HadleyResearch/CardPOV/Documentation/CardPOV_v1.0_BOM.ods

Sheet: BOM
 |  |  |  |  | Document: | Bill of Materials
 |  |  |  |  | Last Modified: | Last_Modified_Date
 |  |  |  |  | Project: | Project Name
 |  |  |  |  | Project Version: | Project_Version
 |  |  |  |  | Author: | Author_Name
Main Board
Description | ID | Qty | Value | Package | Manufacturer | Mfg. Part # | Supplier | Supplier Part #
Microcontroller |  | 1 |  | SSOP-28 | Microchip | PIC18F25J50 | DigiKey | PIC18F25J50-I/SS-ND
Battery Holder |  | 1 |  | Through Hole |  |  | DigiKey | BU2032-1-HD-G-ND
DPST Power Switch |  | 1 |  | 3-Pin PC |  |  | DigiKey | 679-1854-ND
Tact Switch |  | 2 |  | 6mm x 6mm |  |  | DigiKey | 450-1649-ND
Decoupling Capacitor |  | 1 | 0.01uF | 0603 |  |  | DigiKey | 490-1512-1-ND
Current Resistor |  | 7 | 75 ohm | 0805 |  |  | DigiKey | P75ADCT-ND
Pull-up Resistor |  | 2 | 10k ohm | 0805 |  |  | DigiKey | RHM10KKCT-ND
Programming Header |  | 1 |  | 1x5 0.1” Header |  |  | DigiKey | SAM1051-40-ND
CR2032 Battery |  | 1 |  | CR2032 |  |  | DigiKey | P189-ND

Sheet: Config
AtomicBOM Configuration Data:
Parameter | Description | Default Value | Value
maxResults | Maximum number of results to display for part searches (integer) | 5 | 5
maxSuppliers | Maximum number of suppliers to display for part searches (integer) | 5 | 5
suppliersInclude | List of suppliers to include in search results (comma separated list)
suppliersExclude | List of suppliers to exclude in search results (comma separated list)
filterROHS | Return only ROHS compliant parts (1: yes, 0: no) | 0 | 0
cacheParts | Cache part data for more efficient future searches (1: yes, 0: no) | 0 | 0
getDatasheetURLs | Return/embed datasheet URLs, if they exist (1: yes, 0: no) | 1 | 1
getSupplierURLs | Return/embed supplier URLs, if they exist (1: yes, 0: no) | 1 | 1
logging | Enable log information for macro (1: yes, 0: no) | 1 | 1
logFile | Filepath to program log file (string)
logLevel | Number corresponding to logging intensity (0-4) | 2 | 2
bundleParts | Bundle parts from single supplier (reduce shipping costs) | 0 | 0
minBundle | Minimum order (dollar value) for part bundling
versionCheck | Check for new versions of AtomicBOM macro suite | 0 | 0
versionURL | AtomicBOM updated version URL
bomVer | Current version of AtomicBOM macro | 0 | 0
