HadleyResearch/CardPOV/Documentation/Materials_v1r0.xlsx

Date: 1/07/2010
Project: CardPOV
Version: 1
Revision: 0
Description: Bill of Materials
Part | Manufacturer | Supplier | Package | Order No. | Qty.
PIC18F25J50 | Microchip | DigiKey | SSOP-22 | PIC18F25J50-I/SS-ND | 1
CR2032 Battery Holder | MPD | DigiKey | PC Pin | BU2032-1-HD-G-ND | 1
CR2032 Battery | Panasonic BSG | DigiKey | Coin Cell | P189-ND | 1
DPST Power Switch | APEM Components | DigiKey | PC Pin | 679-1854-ND | 1
Tact Switch | Tyco Electronics | DigiKey | 6mm x 6mm | 450-1649-ND | 2
0.01 uF Capacitor | Murata | DigiKey | 0603 | 490-1512-1-ND | 1
75Ω Resistor | Panasonic ECG | DigiKey | 0805 | P75ADCT-ND | 7
10kΩ Resistor | Rohm Semiconductor | DigiKey | 0805 | RHM10KKCT-ND | 2
Male Right Angle Pin Header | Samtec | DigiKey | 1x5 | SAM1051-40-ND | 1
