HadleyResearch/CardPOV/Documentation/ConstructionGuide.odt

Construction Guide

Project: ProjectName

Date: ManualDate

ProjectName Construction Guide

http://nbitwonder.com 2 ©2011 NBitWonder LLC
