HadleyResearch/CardPOV/Documentation/UserManual.odt

User Manual

Project: ProjectName

Date: ManualDate

# 1.0. Introduction

Briefly describe the product, it's purpose, it's function. Describe the items that should have come with the product (all boards, SD card, batteries, etc.). Describe any complementary items that can be used with the product (accessories, etc.)

# 2.0. Usage Information

Information related to the usage of the project. Describe any assembly information needed for this project (if the project doesn't come fully assembled). Detail navigation through any and all software menus. Describe important basic procedures, such as changing the batteries or replacing the SD card.

# 3.0. Safety Information

Their may be some relevant safety issues for your project that users should know. Some are very trivial (choking hazard, keep away from water). Some may be special information relevant to your product (example: if your product contains a laser, a warning about not pointing it in a person's eyes is probably reasonable)

# 4.0. Care Information

Information about maintaining a product. This section might contain information about replacing the batteries, or conditions for storage (ex. store in a cool, dry place). Additionally, any disposal or recycling instructions should be included here.

# 5.0. Support Information

Technical support and other relevant information. This section might include frequently asked questions or common troubleshooting steps. Also, add any contact information (email, website, phone) for additional support information for your product.

# 6.0. Legal Information

Some types of products and equipment may have important legal considerations related to their use (example: for recording equipment, recording private conversations as a third-party is illegal in many states). Provide the user with any important legal information to help keep them, and your company, safe from lawsuits. Additionally, consider adding licensing information (even if you're using an open license) in this section. If your product is to have a warranty, this section is where you'll want to include that.

http://nbitwonder.com 2 [Insert Copyright etc. here]

http://nbitwonder.com 2 ©2011 NBitWonder LLC
