HadleyResearch/CardPOV/Documentation/ProjectNotebook_George.odt

Project Notebook

Project: CardPOV

Author: George Hadley

Hardware Selection:

Entry: 001 Time: 10/19/2009 16:43 UTC Version: 1.0 Title: Initial Design

Microcontroller: A microcontroller with onboard USB and sufficient memory space for future code features is desired. For this, the PIC18F25J50 (http://www.microchip.com/wwwproducts/Devices.aspx?dDocName=en534040), featuring 32k of flash and 2k of data memory, as well as onboard USB, will be used.

Power Source: A slim power source with sufficient capacity to run the onboard circuitry is desired. For this, a CR2032 coin cell battery, providing 3V power and a 230mAh capacity, will be used.

LEDs: Generic through hole or surface mount LEDs.

Switches: Generic tactile switches.

Firmware:

Version 1 will make use primarily of the timer0 peripheral to coordinate the LED pulses. For static timing purposes, it will be assumed that the POV will be moved repetitively through a linear path approximately 30” in length. POV characters will be stored in the onboard data EEPROM memory, and target operational frequency is 8MHz.

Pin Usage:

Of particular importance for the initial layout of CardPOV, pins should be selected in such a way so as not to conflict with future pin needs. For this reason, pins that are needed for the USB, comparator, and ADC should not be used. Initial pin declarations are as follows:

Pushbutton 1: RC0 (pin 11)

Pushbutton 2 (available): RC1 (pin 12)

Pushbutton 3 (available): RC2 (pin 13)

POV LEDs: RB5-RB0, RC7, RC6 (pins 26-21, 18, 17)

Work continued on CardPOV v1.0 yesterday, but was quickly brought to a halt when the following problems arose:

Entry: 002 Time: 1/8/2010 16:55 UTC Version: 1.0 Title: Ordering and PCB Errors

1. An ordering error resulted in the accidental purchase of PIC18LF25J50 microcontrollers instead of PIC18F25J50 microcontrollers
2. A second ordering error resulted in the accidental procurement of 0.75Ω resistors instead of 75Ω resistors.
3. In the PCB layout, ground was referred to by 2 different names (GND and VSS), and as such these 2 nets were not correctly connected, resulting in incomplete circuit connections to the LEDs.

To help mitigate these problems in the future, I plan to check orders and PCB layouts more carefully.

I corrected the error to version 1 of the CardPOV board, and the resulting board operated properly. As such, the hardware for CardPOV v1 is now stable. Firmware will be stable for the CardPOV v1 device once I incorporate the multiple string support feature.

Entry: 003 Time: 1/17/2010 15:02 UTC Version: 1.0 Title: CardPOV LED Improvements

On a sidenote, while working on CardPOV v1 today, Karen came up with 2 great ideas for the CardPOV device. First, when this device goes up for sale, she suggested that I could allow users to pick the POV color that they want (good business idea). Second, she suggested moving away from red as a POV color and instead using blue, green, or teal. This makes a lot of sense as the human eye has a much better response to these colors than red (optimal response for teal), which means I could considerably increase the POV display's visibility without an increase in LED intensity of power.

Included below is a table of POV colors, voltages, and resistor values for different LED colors:

Color | Forward Voltage | Resistor (ohm)
Red | 1.5 | 175
Orange | 2.1 | 145
Yellow | 2.4 | 130
Green | 2.2 | 140
Teal | 3.2 | 90
Blue | 3 | 100
Purple | 3.2 | 90
Pink | 3.2 | 90
White | 3.3 | 85

Fig. 1. POV LED Characteristics

I spent a considerable amount of time yesterday working on multiple string support code for the CardPOV project. Currently, POV string data is written starting at address 0800h. The first value is the number of POV signs in memory, followed by a series of entries consisting of the length of a given sign and its starting location in memory.

Entry: 004 Time: 1/30/2010 15:15 UTC Version: 1.0 Title: Firmware v1.0 Issues

The code has thus far presented me with a few difficulties, some of which remain unsolved. The first major mystery was that when I programmed the circuit with the Pickit2 in debug mode, it wouldn’t work as a standalone device, the PICKit was required for operation. In an attempt to remedy this, I used the config directive supported by the pic18f devices and added the configuration bits to the code. A complete listing of all of the configuration bits and their symbolic values for the config directive can be found in the .inc file of the PIC microcontroller in use. That alone did not fix the problem, however. I later discovered that when programming a PIC microcontroller with the debugger, the debugger inserts bits of code that require the circuit to be used with the debugger to work properly.

As of the time of this writing, one other error still eludes me, however. For reasons thus far unidentified, bit 0 of portA does not register a value of 1 when 3.3V is applied, in spite of the fact that it is set up as an input in the trisA register.

Having tried using a different pin on port A and checking the silicon errata, the button debouncing problem blocking the path to multiple string support remained a mystery. Fortunately, with the help of a nice fellow from the Microchip online forums, it was revealed that the analog control register ANCON0 is banked and not accessible from the default bank select register upon a reset. As such, the values that I was writing to the ANCON0 register were not actually being written, and as a result the portA pins were being used as analog inputs (instead of digital inputs). By changing the bank select register to bank F, I gained write access to the ANCON0 register, which allowed me to initialize portA as digital I/O and fixed the error. With that error fixed, multiple string support is working by and large.

Entry: 005 Time: 2/08/2010 15:18 UTC Version: 1.0 Title: Firmware Analog Issues

With multiple string support supported, CardPOV v1 was nearly finished. Still, a few lingering errors seem to be latent in the hardware, and these needed to be investigated. In particular, the display was still a bit unreadable, debouncing of the string select pushbutton appeared to be incomplete, and there’s an unusual artifact of some kind present in the first string (“NBitWonder”) POV output. After uping the timer prescaler (moving from 1:32 -> 1:64), the POV display appeared to be more readable. The button debouncing problem that appeared to be there seemed to go away after the device was reprogrammed. The artifact still remains, however, but that will hopefully be addressed soon.

Entry: 006 Time: 2/014/2010 15:19 UTC Version: 1.0 Title: POV Readability

It's been a long time since any substantial progress has been made on the CardPOV project, but it's time to move forward and make some additional progress on the project. Dangerous Prototypes has a USB POV (http://dangerousprototypes.com/docs/USB_POV_Toy) currently in the prototype stage, so the CardPOV project will need to offer additional features to be competitive with the upcoming DP project. With that in mind, the following improvements are proposed for CardPOV v2.0:

Entry: 007 Time: 6/15/2011 17:01 UTC Version: 1.0 Title: CardPOV v2.0 Planning

1. Onboard mini (micro?) USB connector
2. USB bootloader and programming capability
3. Cross-platform Windows/Mac/Linux GUI for programming the POV device
4. Provision for an external interrupt signal to trigger the POV device instead of a fixed timing rate
5. Rechargeable coin cell battery (rechargeable over USB)

In order to accomplish this desired functionality, a bootloader will be required that works on 8-bit PIC microcontrollers. A survey of available open source bootloaders reveals the following options at the time of this writing:

- The Colt Bootloader (http://mdubuc.freeshell.org/Colt/) created by user mdubuc of freeshell.org is a bootloader based off of the PIC18 bootloader code provided by Microchip technologies. The bootloader is written in Visual C++, and claims to be generic enough to work with any PIC18F family microcontroller. The bootloader is not known to have been tested with the PIC18F2xK22 or PIC18F25J50 devices, so it is not known what level of development work is necessary to get the bootloader to function with the candidate devices for CardPOV v2.0. Additionally, there is no mention of licensing and distribution requirements for the Jolt/Colt bootloader code, so this must be determined as well. Finally, while there is a bootloader application suitable for working with Jolt/Colt in the Windows environment, a GUI is lacking, and cross-platform compatibility is desired. The bootloader code hasn't been updated in quite some time, so it is not known if this project is still being actively developed.
- The Diolan PIC Bootloader (http://www.diolan.com/pic/bootloader.html) by Diolan claims to be open source, and features cross-platform compatibility (Windows, Linux, Mac OSX). At 2kB it's four times larger than the Jolt/Colt bootloader, but this shouldn't matter for the candidate devices for CardPOV v2.0. The Diolan bootloader has been updated more recently than the Jolt/Colt bootloader, and the available documentation appears to be considerably better than that available for the Jolt/Colt bootloader.

George Hadley CardPOV Project Notebook

http://nbitwonder.com 5 ©2011 NBitWonder LLC
