HadleyResearch/CardPOV/(commit log)

2010-11-15 Initial repository created.
    [Materials_v1r0.xlsx, POVTable.xls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]
2011-01-07 Pushed old documentation to Documentation/Old, set up v1.0 documentation using open documentation templates
    [Materials_v1r0.xlsx, POVTable.xls]
2011-10-07 Repository update, documentation overhaul
    The CardPOV repository was overhauled to reflect the new standardized directory
    structure, available at https://github.com/NBitWonder/NewProject
    Documentation was organized and completely rewritten using the NBitWonder Open
    Documentation System, with OpenOffice templates available at:
    https://github.com/NBitWonder/ProjectTemplates-OpenOffice
    The following pieces of documentation are complete:
    +Project Overview
    +Project Notebook
    +Bill of Materials
    [CardPOV_v1.0_BOM.ods, CardPOVv1.1.brd, CardPOVv1.1.sch, POVTable.xls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]
2011-10-11 Removed redundant repository items
    [CardPOVv1.1.brd, CardPOVv1.1.sch, Materials_v1r0.xlsx, POVTable.xls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]
